hex-255/I2C-Sensorboard/README.md

# I2C-Sensorboard
Arduino Clone with multitude of I2C Sensors on-board meant as a learning platform for embedded programming
