hex-255/I2C-Sensorboard/I2C Sensor Board_V2/Write_Screenshots/16x2_Dimensions.png

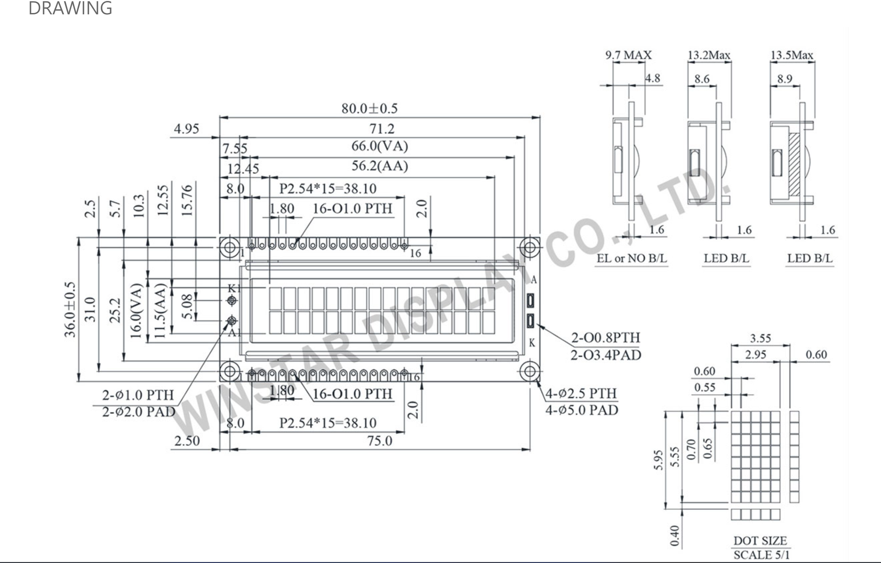
I2C Sensor Board_V2/Write_Screenshots/16x2_Dimensions.png
