hex-255/I2C-Sensorboard/I2C Sensor Board_V2/Write_Screenshots/Footpr_Assign_2.png

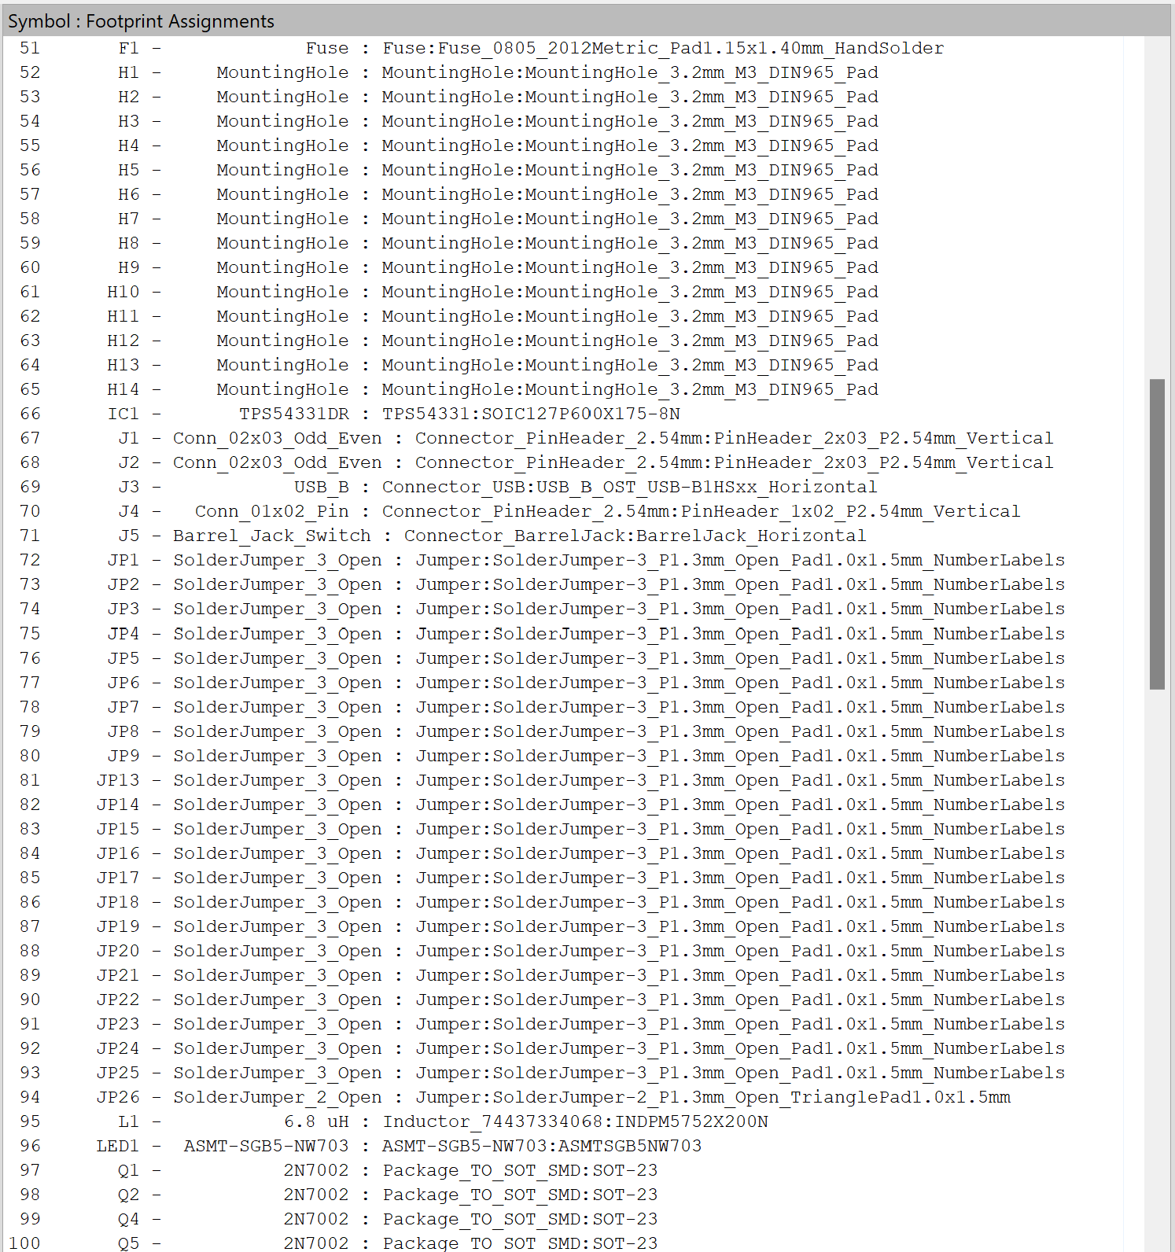
I2C Sensor Board_V2/Write_Screenshots/Footpr_Assign_2.png
