hex-255/I2C-Sensorboard/I2C Sensor Board_V2/Write_Screenshots/Footpr_Assign_3.png

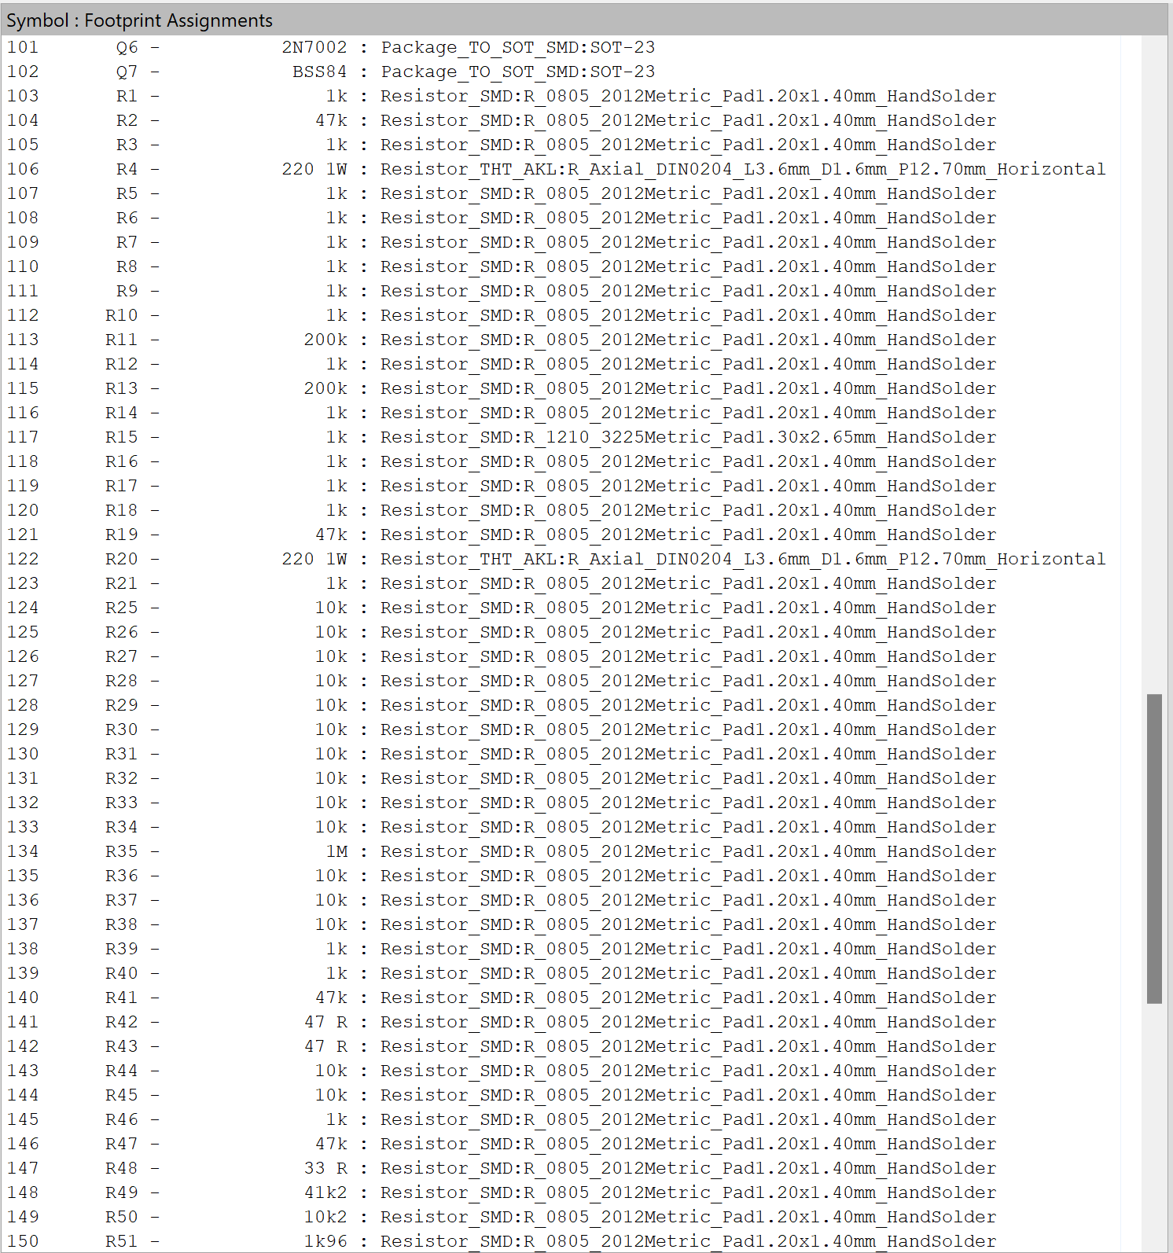
I2C Sensor Board_V2/Write_Screenshots/Footpr_Assign_3.png
