hex-255/I2C-Sensorboard/I2C Sensor Board_V2/Write_Screenshots/sch_DAC.png

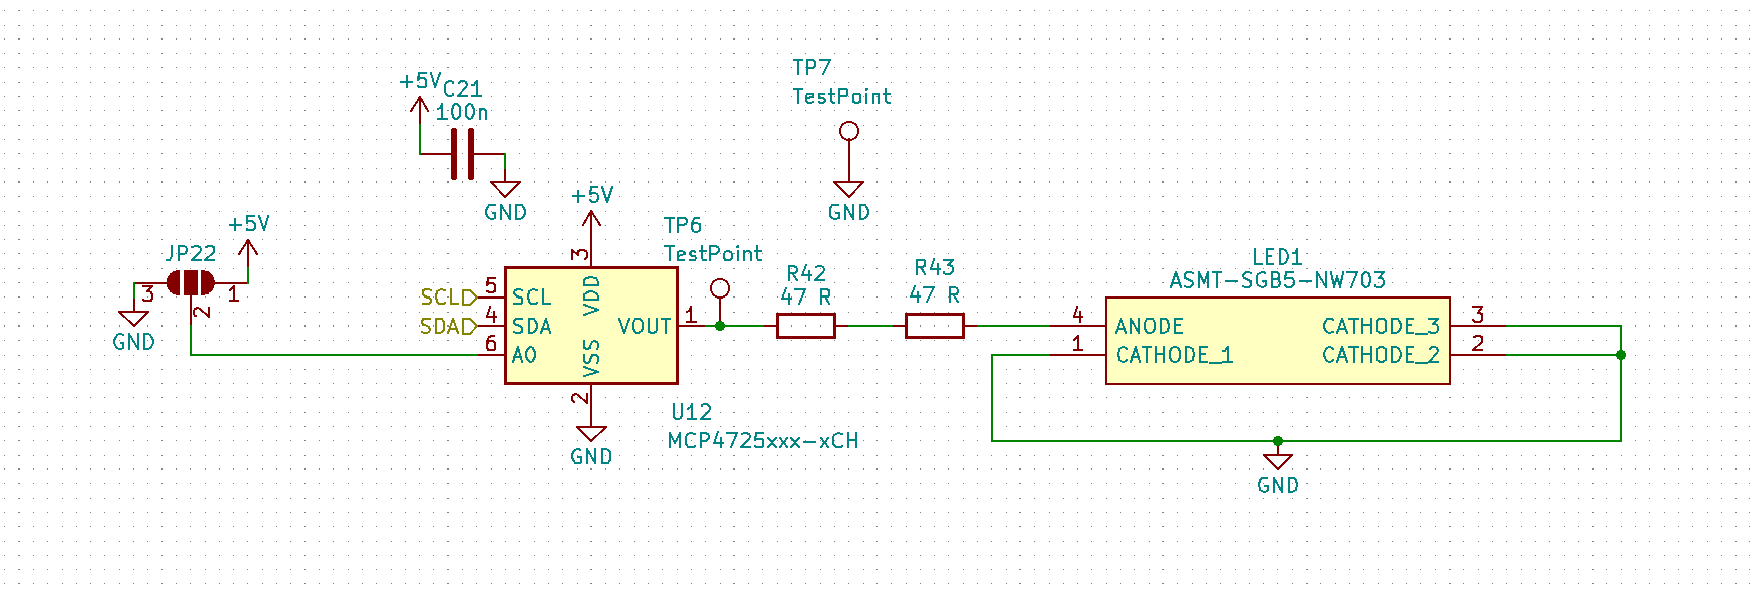
I2C Sensor Board_V2/Write_Screenshots/sch_DAC.png
