hex-255/I2C-Sensorboard/I2C Sensor Board_V2/Write_Screenshots/sch_EEPROM.png

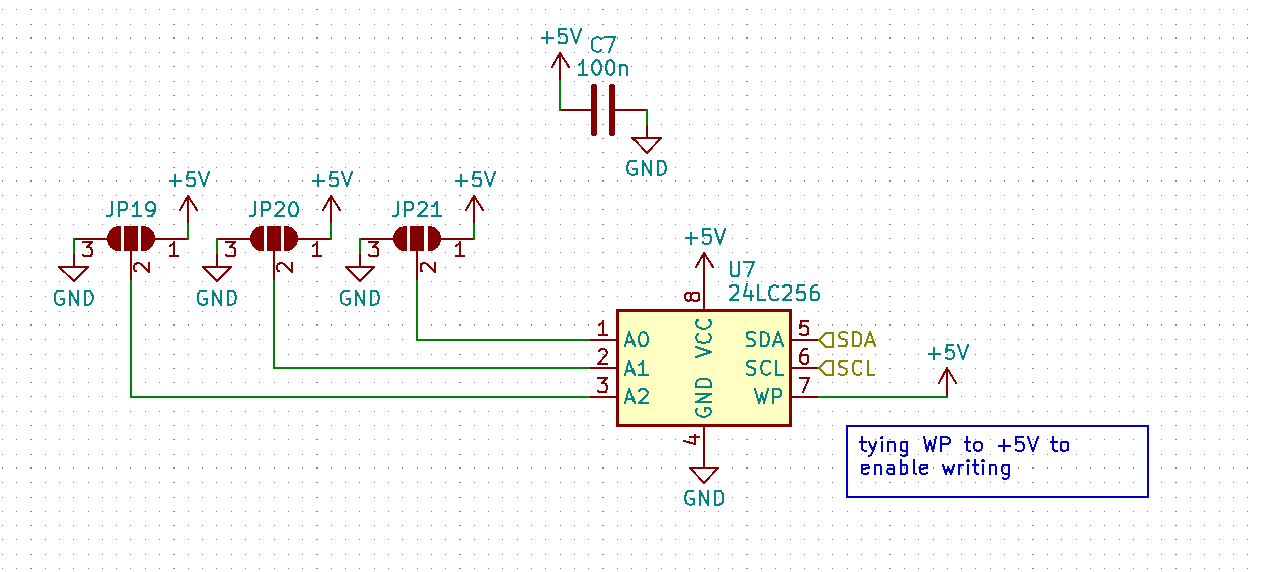
I2C Sensor Board_V2/Write_Screenshots/sch_EEPROM.png
