hex-255/I2C-Sensorboard/I2C Sensor Board_V2/Write_Screenshots/sch_LM75.png

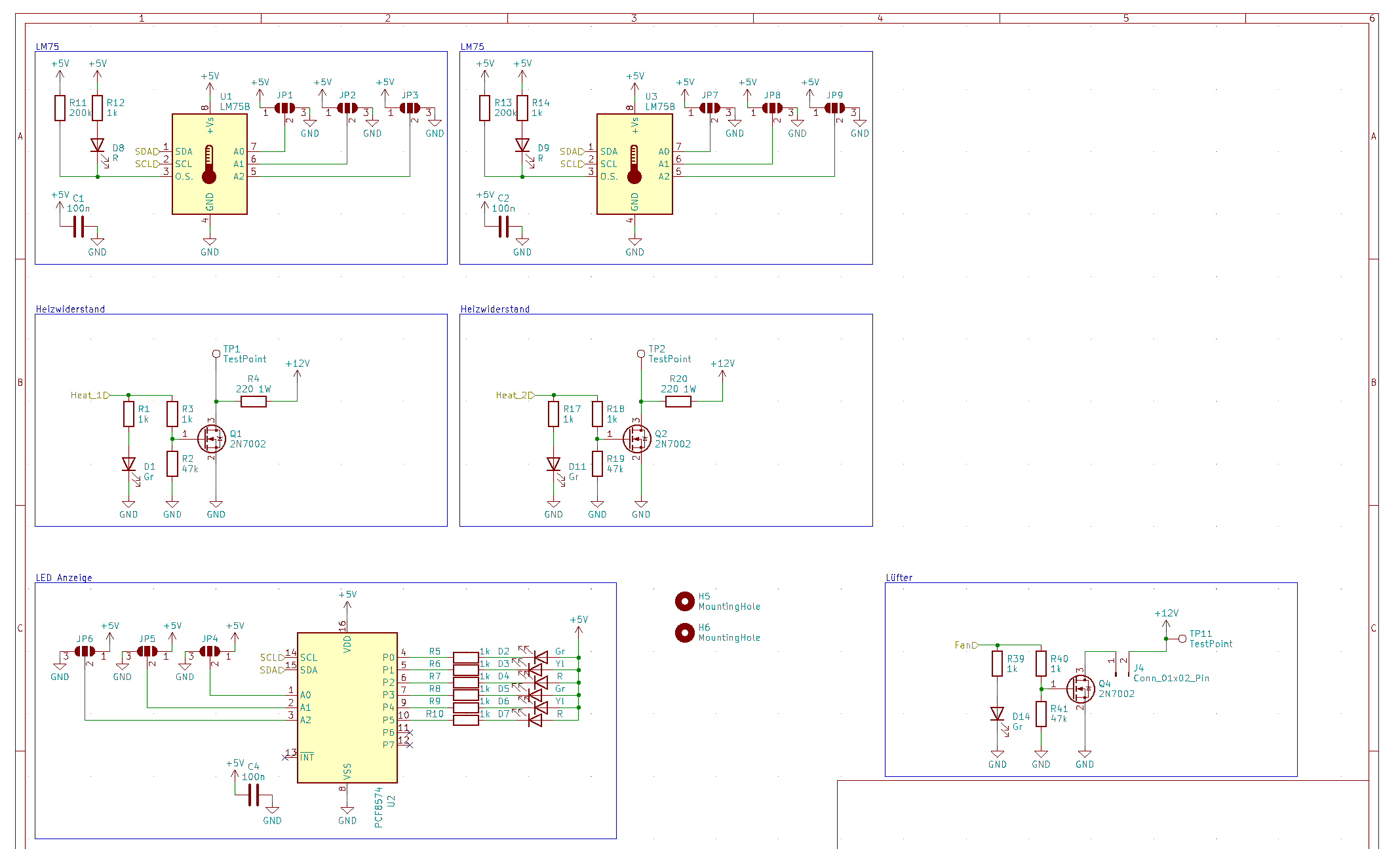
I2C Sensor Board_V2/Write_Screenshots/sch_LM75.png
