hex-255/I2C-Sensorboard/I2C Sensor Board_V2/Component_Placement.png

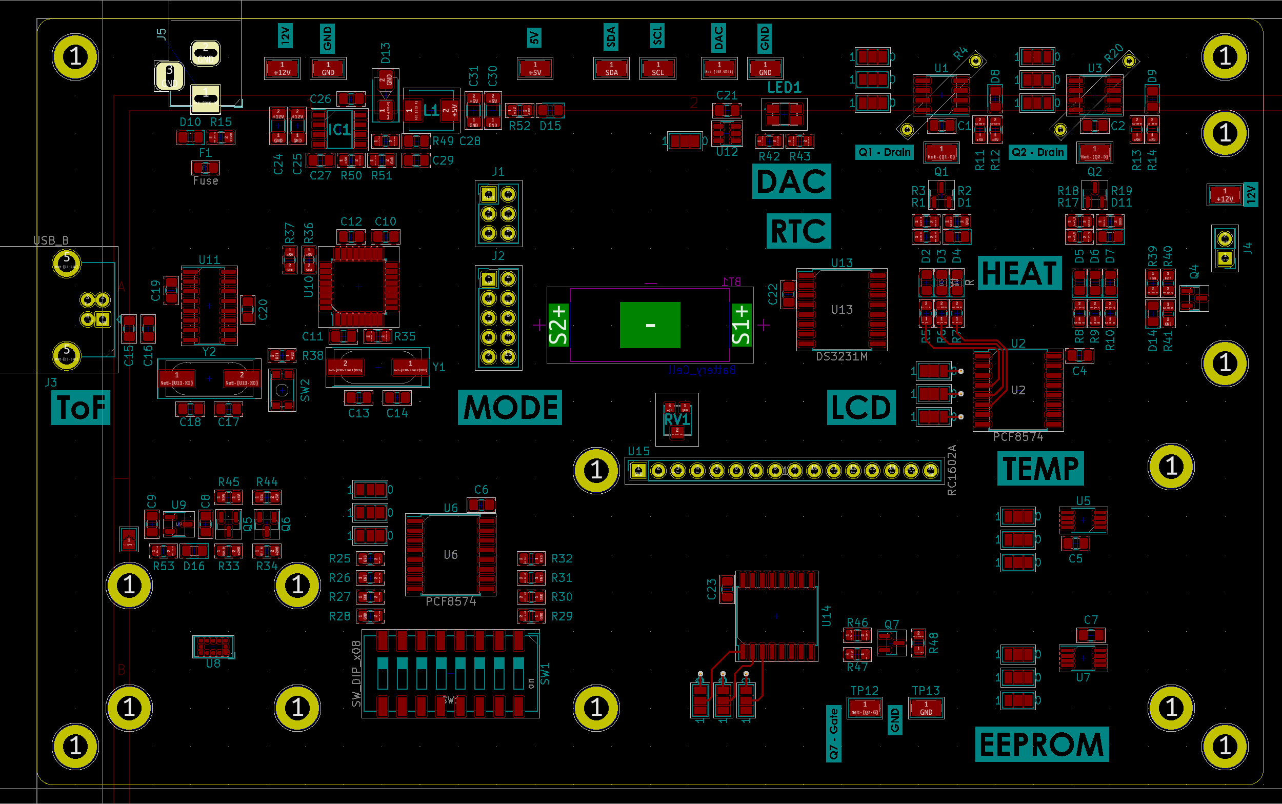
I2C Sensor Board_V2/Component_Placement.png
