hex-255/I2C-Sensorboard/I2C Sensor Board_V2/I2C Sensor Board_V2.step

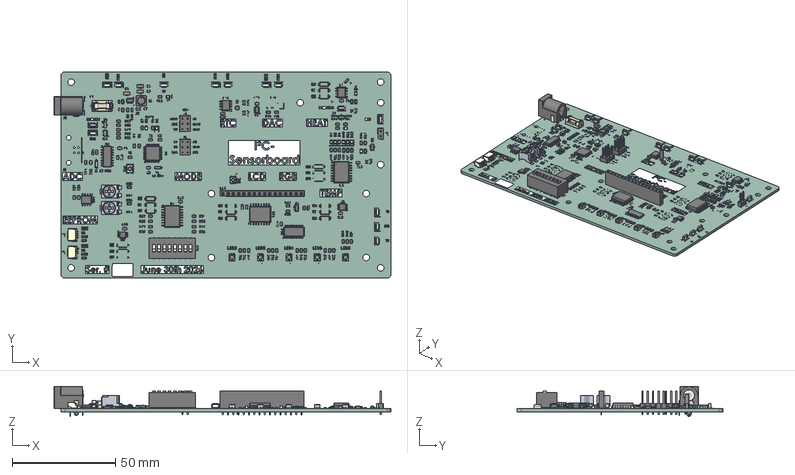
[picture p19: CAD file, 2026-10-06]
I2C Sensor Board_V2/I2C Sensor Board_V2.step
163.3 x 100.0 x 14.6 mm
R_0805_2012Metric x 59
150141M173100 x 10
SOIC-8_3.9x4.9mm_P1.27mm x 3
shielding ring x 3
core
coil
C_0805_2012Metric x 22
SOT-23-6
SOIC-16W_7.5x10.3mm_P1.27mm x 3
LED_0805_2012Metric x 12
CSTNE12M0G550000R0 x 2
SM04B-SRSS-TB(LF)(SN)--3DModel-STEP-269445 x 2
Crystal_Round_D2.0mm_Vertical
SW_DIP_SPSTx08_Slide_9.78x22.5mm_W8.61mm_P2.54mm
TC33X-2-103E
TQFP-32_7x7mm_P0.8mm
PinsArrayL x 2
FilletPinR
SOT-23 x 3
154005-DR
TSSOP-28_4.4x9.7mm_P0.65mm
N6L50T0S-CARCASA x 2
N6L50T0S-TERMINAL COLECTOR x 2
N6L50T0S-PLACA x 2
N6L50T0S-PORTACURSOR x 2
N6L50T0S-TOPE x 2
BarrelJack_Horizontal
SOIC-16_3.9x9.9mm_P1.27mm
PinHeader_2x03_P2.54mm_Vertical x 2
PinHeader_1x02_P2.54mm_Vertical
MSOP-8_3x3mm_P0.65mm x 2
KMR221GLFS--3DModel-STEP-56544
PinSocket_1x16_P2.54mm_Vertical
PinsArrayR
TSOT-23-6
C_1206_3216Metric x 3
I2C Sensor Board_V2_silkscreen x 2
I2C Sensor Board_V2_PCB
