hex-255/I2C-Sensorboard/I2C Sensor Board_V2/I2C Sensor Board_V2.kicad_pcb

## KiCad design I2C Sensor Board_V2/I2C Sensor Board_V2.kicad_pcb (2026-10-06)

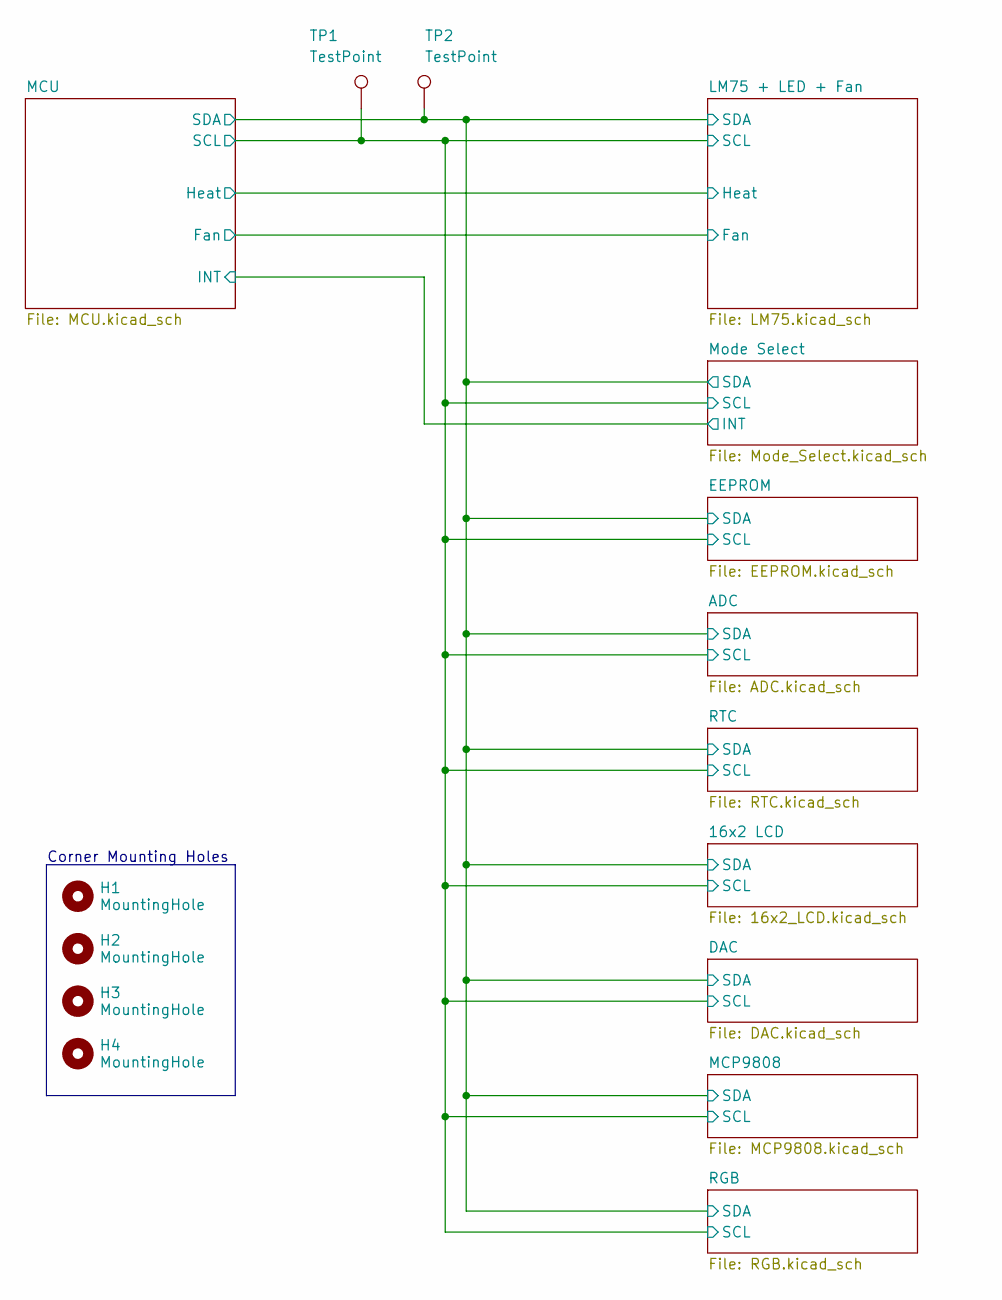
[picture p20: schematic I2C Sensor Board_V2.kicad_sch]

Parts:
H1, H2, H3, H4: MountingHole; MountingHole_3.2mm_M3_DIN965_Pad
TP1, TP2: TestPoint; Testpoint_5019_HandSolder

Connections:
/MCU/SCL: TP1.1 (1_1); also elsewhere on the board
/MCU/SDA: TP2.1 (1_1); also elsewhere on the board

Notes on the sheet:
Corner Mounting Holes

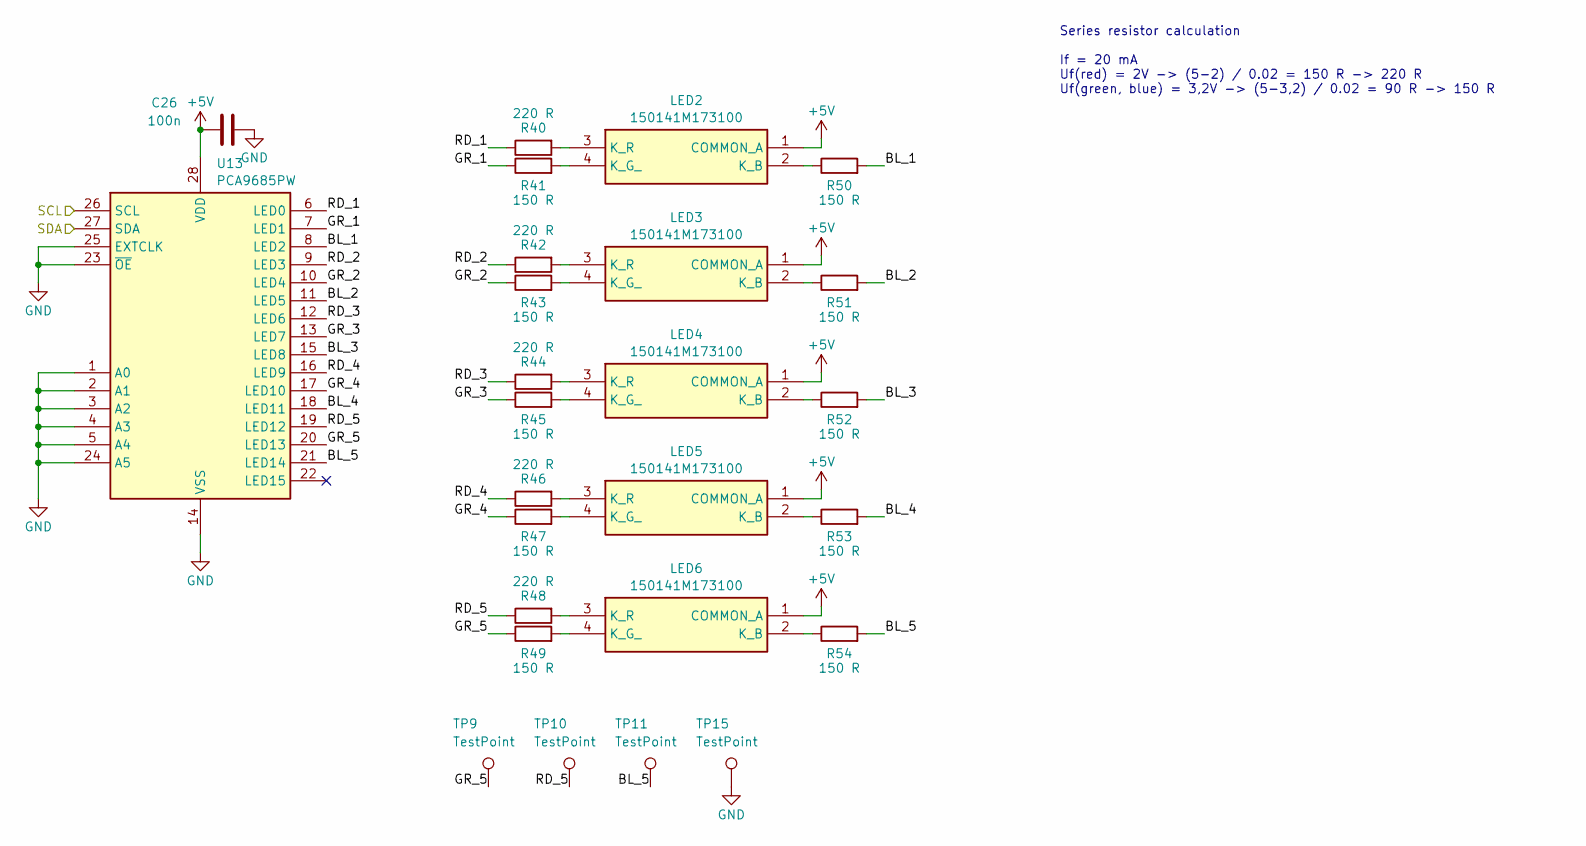
[picture p21: schematic RGB.kicad_sch]

Parts:
C26: 100n; C_0805_2012Metric_Pad1.18x1.45mm_HandSolder
LED2, LED3, LED4, LED5, LED6: 150141M173100; Manufacturer_Part_Number 150141M173100; Mouser Part Number 710-150141M173100
R40, R42, R44, R46, R48: 220 R; R_0805_2012Metric_Pad1.20x1.40mm_HandSolder
R41, R43, R45, R47, R49, R50, R51, R52, R53, R54: 150 R; R_0805_2012Metric_Pad1.20x1.40mm_HandSolder
TP9, TP10, TP11, TP15: TestPoint; Testpoint_5019_HandSolder
U13: PCA9685PW; TSSOP-28_4.4x9.7mm_P0.65mm

Connections:
+5V: C26.1, LED2.1 (COMMON_A), LED3.1 (COMMON_A), LED4.1 (COMMON_A), LED5.1 (COMMON_A), LED6.1 (COMMON_A), U13.28 (VDD); also elsewhere on the board
/MCU/SCL: U13.26 (SCL); also elsewhere on the board
/MCU/SDA: U13.27 (SDA); also elsewhere on the board
/RGB/BL_1: R50.2, U13.8 (LED2)
/RGB/BL_2: R51.2, U13.11 (LED5)
/RGB/BL_3: R52.2, U13.15 (LED8)
/RGB/BL_4: R53.2, U13.18 (LED11)
/RGB/BL_5: R54.2, TP11.1 (1_1), U13.21 (LED14)
/RGB/GR_1: R41.1, U13.7 (LED1)
/RGB/GR_2: R43.1, U13.10 (LED4)
/RGB/GR_3: R45.1, U13.13 (LED7)
/RGB/GR_4: R47.1, U13.17 (LED10)
/RGB/GR_5: R49.1, TP9.1 (1_1), U13.20 (LED13)
/RGB/RD_1: R40.1, U13.6 (LED0)
/RGB/RD_2: R42.1, U13.9 (LED3)
/RGB/RD_3: R44.1, U13.12 (LED6)
/RGB/RD_4: R46.1, U13.16 (LED9)
/RGB/RD_5: R48.1, TP10.1 (1_1), U13.19 (LED12)
GND: C26.2, TP15.1, U13.1 (A0), U13.2 (A1), U13.3 (A2), U13.4 (A3), U13.5 (A4), U13.14 (VSS), U13.23 (~OE), U13.24 (A5), U13.25 (EXTCLK); also elsewhere on the board
unnamed: LED2.2 (K_B), R50.1
unnamed: LED2.4 (K_G_), R41.2
unnamed: LED2.3 (K_R), R40.2
unnamed: LED3.2 (K_B), R51.1
unnamed: LED3.4 (K_G_), R43.2
unnamed: LED3.3 (K_R), R42.2
unnamed: LED4.2 (K_B), R52.1
unnamed: LED4.4 (K_G_), R45.2
unnamed: LED4.3 (K_R), R44.2
unnamed: LED5.2 (K_B), R53.1
unnamed: LED5.4 (K_G_), R47.2
unnamed: LED5.3 (K_R), R46.2
unnamed: LED6.2 (K_B), R54.1
unnamed: LED6.4 (K_G_), R49.2
unnamed: LED6.3 (K_R), R48.2

Notes on the sheet:
Series resistor calculation If = 20 mA Uf(red) = 2V -> (5-2) / 0.02 = 150 R -> 220 R Uf(green, blue) = 3,2V -> (5-3,2) / 0.02 = 90 R -> 150 R

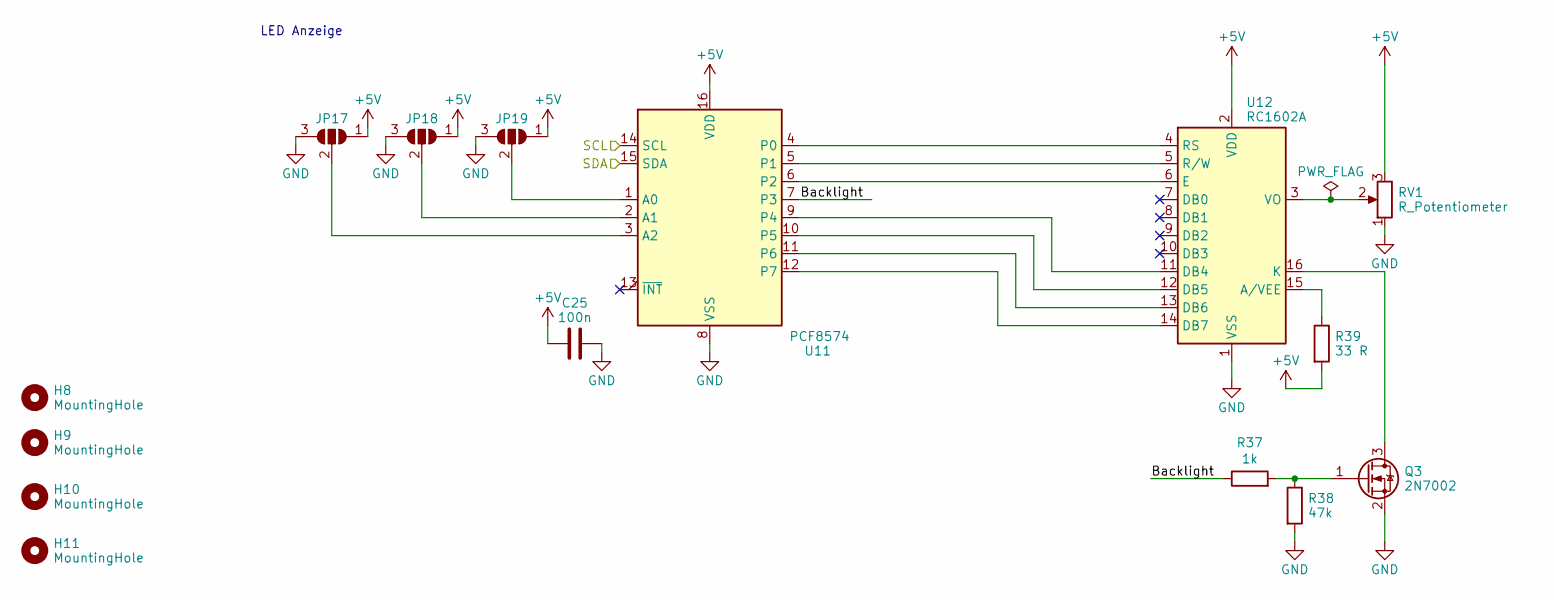
[picture p22: schematic 16x2_LCD.kicad_sch]

Parts:
C25: 100n; C_0805_2012Metric_Pad1.18x1.45mm_HandSolder
H8, H9, H10, H11: MountingHole; MountingHole_3.2mm_M3_DIN965_Pad
JP17, JP18, JP19: SolderJumper_3_Open; SolderJumper-3_P1.3mm_Open_Pad1.0x1.5mm_NumberLabels
Q3: 2N7002; SOT-23
R37: 1k; R_0805_2012Metric_Pad1.20x1.40mm_HandSolder
R38: 47k; R_0805_2012Metric_Pad1.20x1.40mm_HandSolder
R39: 33 R; R_0805_2012Metric_Pad1.20x1.40mm_HandSolder
RV1: R_Potentiometer; TRIM_TC33X-2-103E
U11: PCF8574; SOIC-16W_7.5x10.3mm_P1.27mm
U12: RC1602A; PinSocket_1x16_P2.54mm_Vertical

Connections:
+5V: C25.1, JP17.1 (A), JP18.1 (A), JP19.1 (A), R39.2, RV1.3, U11.16 (VDD), U12.2 (VDD); also elsewhere on the board
/16x2 LCD/Backlight: R37.1, U11.7 (P3)
/MCU/SCL: U11.14 (SCL); also elsewhere on the board
/MCU/SDA: U11.15 (SDA); also elsewhere on the board
GND: C25.2, JP17.3 (B), JP18.3 (B), JP19.3 (B), Q3.2 (S), R38.2, RV1.1, U11.8 (VSS), U12.1 (VSS); also elsewhere on the board
unnamed: JP17.2 (C), U11.3 (A2)
unnamed: JP18.2 (C), U11.2 (A1)
unnamed: JP19.2 (C), U11.1 (A0)
unnamed: Q3.3 (D), U12.16 (K)
unnamed: Q3.1 (G), R37.2, R38.1
unnamed: U11.4 (P0), U12.4 (RS)
unnamed: U11.5 (P1), U12.5 (R/W)
unnamed: U11.6 (P2), U12.6 (E)
unnamed: U11.9 (P4), U12.11 (DB4)
unnamed: U11.10 (P5), U12.12 (DB5)
unnamed: U11.11 (P6), U12.13 (DB6)
unnamed: U11.12 (P7), U12.14 (DB7)
unnamed: R39.1, U12.15 (A/VEE)
unnamed: RV1.2, U12.3 (VO)

Notes on the sheet:
LED Anzeige

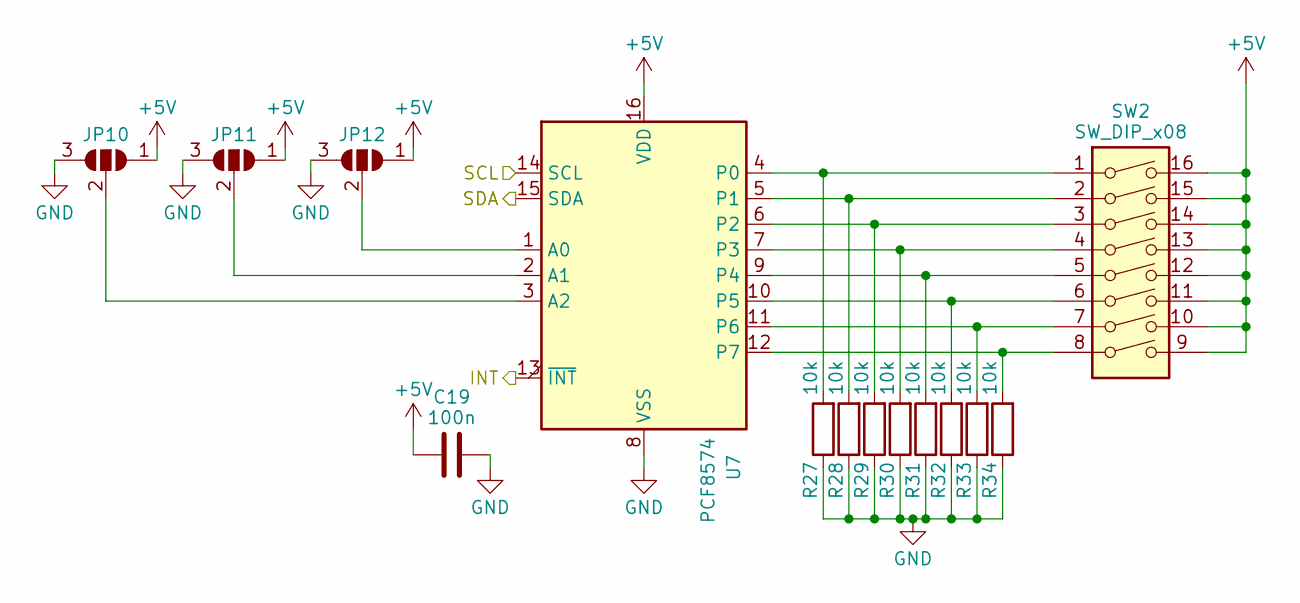
[picture p23: schematic Mode_Select.kicad_sch]

Parts:
C19: 100n; C_0805_2012Metric_Pad1.18x1.45mm_HandSolder
JP10, JP11, JP12: SolderJumper_3_Open; SolderJumper-3_P1.3mm_Open_Pad1.0x1.5mm_NumberLabels
R27, R28, R29, R30, R31, R32, R33, R34: 10k; R_0805_2012Metric_Pad1.20x1.40mm_HandSolder
SW2: SW_DIP_x08; SW_DIP_SPSTx08_Slide_9.78x22.5mm_W8.61mm_P2.54mm
U7: PCF8574; SOIC-16W_7.5x10.3mm_P1.27mm

Connections:
+5V: C19.1, JP10.1 (A), JP11.1 (A), JP12.1 (A), SW2.9, SW2.10, SW2.11, SW2.12, SW2.13, SW2.14, SW2.15, SW2.16, U7.16 (VDD); also elsewhere on the board
/MCU/INT: U7.13 (~INT); also elsewhere on the board
/MCU/SCL: U7.14 (SCL); also elsewhere on the board
/MCU/SDA: U7.15 (SDA); also elsewhere on the board
GND: C19.2, JP10.3 (B), JP11.3 (B), JP12.3 (B), R27.1, R28.1, R29.1, R30.1, R31.1, R32.1, R33.1, R34.1, U7.8 (VSS); also elsewhere on the board
unnamed: JP10.2 (C), U7.3 (A2)
unnamed: JP11.2 (C), U7.2 (A1)
unnamed: JP12.2 (C), U7.1 (A0)
unnamed: R27.2, SW2.1, U7.4 (P0)
unnamed: R28.2, SW2.2, U7.5 (P1)
unnamed: R29.2, SW2.3, U7.6 (P2)
unnamed: R30.2, SW2.4, U7.7 (P3)
unnamed: R31.2, SW2.5, U7.9 (P4)
unnamed: R32.2, SW2.6, U7.10 (P5)
unnamed: R33.2, SW2.7, U7.11 (P6)
unnamed: R34.2, SW2.8, U7.12 (P7)

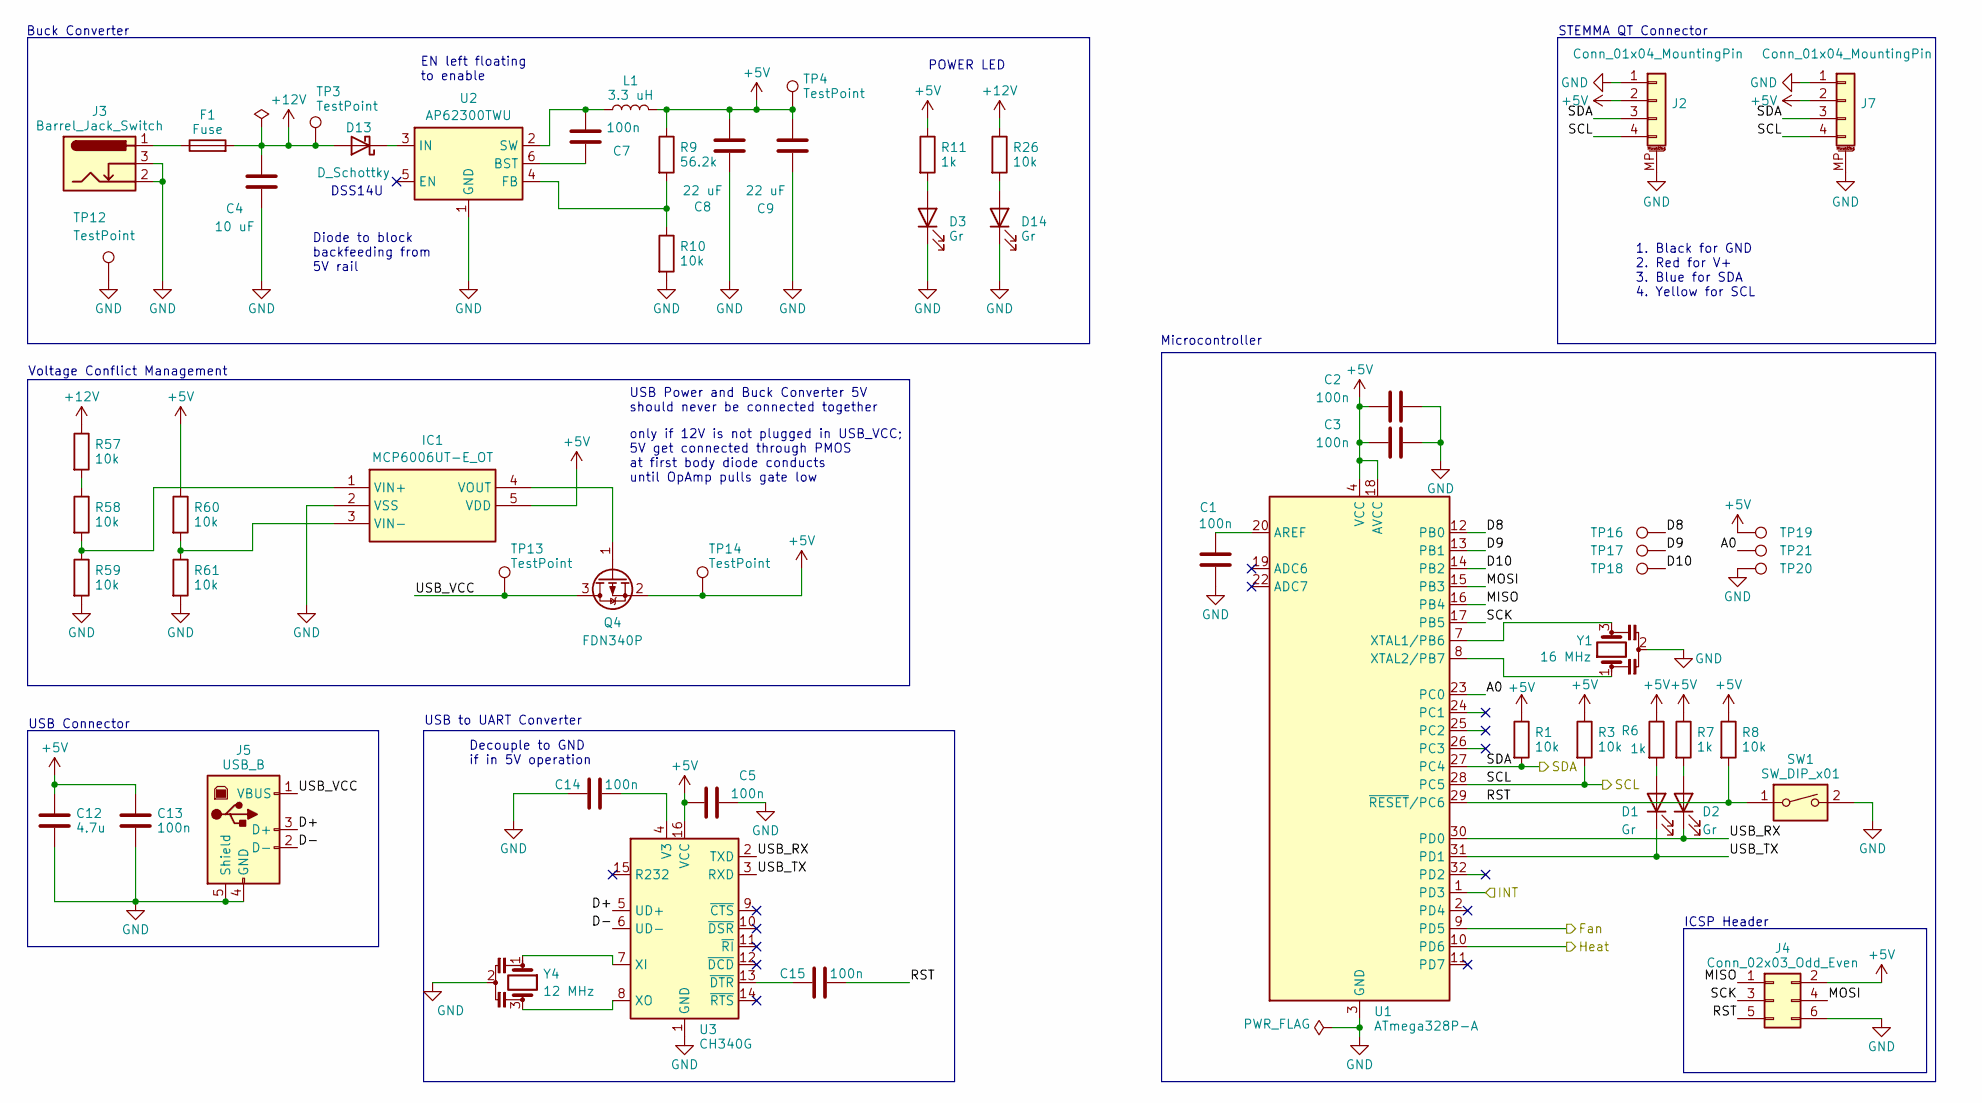
[picture p24: schematic MCU.kicad_sch]

Parts:
C1, C2, C3, C5, C7, C13, C14, C15: 100n; C_0805_2012Metric_Pad1.18x1.45mm_HandSolder
C4: 10 uF; C_1206_3216Metric_Pad1.33x1.80mm_HandSolder
C8, C9: 22 uF; C_1206_3216Metric_Pad1.33x1.80mm_HandSolder
C12: 4.7u; C_0805_2012Metric_Pad1.18x1.45mm_HandSolder
D1, D2, D3, D14: Gr; LED_0805_2012Metric_Pad1.15x1.40mm_HandSolder
D13: D_Schottky; D_SOD-123F
F1: Fuse; 154005DR
IC1: MCP6006UT-E_OT; SOT95P280X145-5N; Manufacturer_Part_Number MCP6006UT-E/OT; Mouser Part Number 579-MCP6006UT-E/OT
J2, J7: Conn_01x04_MountingPin; JST_SH_SM04B-SRSS-TB_1x04-1MP_P1.00mm_Horizontal
J3: Barrel_Jack_Switch; BarrelJack_Horizontal
J4: Conn_02x03_Odd_Even; PinHeader_2x03_P2.54mm_Vertical
J5: USB_B; USB_B_OST_USB-B1HSxx_Horizontal
L1: 3.3 uH; IND_WE-HEPC_5030_WRE
Q4: FDN340P; SOT-23
R1, R3, R8, R10, R26, R57, R58, R59, R60, R61: 10k; R_0805_2012Metric_Pad1.20x1.40mm_HandSolder
R6, R7, R11: 1k; R_0805_2012Metric_Pad1.20x1.40mm_HandSolder
R9: 56.2k; R_0805_2012Metric_Pad1.20x1.40mm_HandSolder
SW1: SW_DIP_x01; SW_Push_1P1T_NO_CK_KMR2
TP3, TP4, TP12, TP13, TP14: TestPoint; Testpoint_5019_HandSolder
TP16, TP17, TP18, TP19, TP20, TP21: TestPoint; TestPoint_THTPad_D1.5mm_Drill0.7mm
U1: ATmega328P-A; TQFP-32_7x7mm_P0.8mm
U2: AP62300TWU; TSOT-23-6
U3: CH340G; SOIC-16_3.9x9.9mm_P1.27mm
Y1: 16 MHz; OSC_CSTNE12M0G550000R0
Y4: 12 MHz; OSC_CSTNE12M0G550000R0

Connections:
+5V: C2.1, C3.1, C5.1, C8.2, C9.2, C12.2, C13.2, IC1.5 (VDD), J2.2, J4.2, J7.2, L1.2, Q4.2 (S), R1.1, R3.1, R6.1, R7.1, R8.1, R9.1, R11.1, R60.1, TP4.1 (1_1), TP14.1 (1_1), TP19.1 (1_1), U1.4 (VCC), U1.6 (VCC), U1.18 (AVCC), U3.16 (VCC); also elsewhere on the board
+12V: C4.2, D13.2 (A), F1.2, R26.1, R57.1, TP3.1 (1_1); also elsewhere on the board
/LM75 + LED + Fan/Fan: U1.9 (PD5); also elsewhere on the board
/LM75 + LED + Fan/Heat: U1.10 (PD6); also elsewhere on the board
/MCU/A0: TP21.1 (1_1), U1.23 (PC0)
/MCU/D8: TP16.1 (1_1), U1.12 (PB0)
/MCU/D9: TP17.1 (1_1), U1.13 (PB1)
/MCU/D10: TP18.1 (1_1), U1.14 (PB2)
/MCU/D+: J5.3 (D+), U3.5 (UD+)
/MCU/D-: J5.2 (D-), U3.6 (UD-)
/MCU/INT: U1.1 (PD3); also elsewhere on the board
/MCU/MISO: J4.1, U1.16 (PB4)
/MCU/MOSI: J4.4, U1.15 (PB3)
/MCU/RST: C15.2, J4.5, R8.2, SW1.1, U1.29 (~RESET/PC6)
/MCU/SCK: J4.3, U1.17 (PB5)
/MCU/SCL: J2.4, J7.4, R3.2, U1.28 (PC5); also elsewhere on the board
/MCU/SDA: J2.3, J7.3, R1.2, U1.27 (PC4); also elsewhere on the board
/MCU/USB_RX: D2.1 (K), U1.30 (PD0), U3.2 (TXD)
/MCU/USB_TX: D1.1 (K), U1.31 (PD1), U3.3 (RXD)
/MCU/USB_VCC: J5.1 (VBUS), Q4.3 (D), TP13.1 (1_1)
GND: C1.1, C2.2, C3.2, C4.1, C5.2, C8.1, C9.1, C12.1, C13.1, C14.1, D3.1 (K), D14.1 (K), IC1.2 (VSS), J2.1, J2.MP (MountPin), J3.2, J3.3, J4.6, J5.4 (GND), J5.5 (Shield), J7.1, J7.MP (MountPin), R10.2, R59.2, R61.2, SW1.2, TP12.1 (1_1), TP20.1 (1_1), U1.3 (GND), U1.5 (GND), U1.21 (GND), U2.1 (GND), U3.1 (GND), Y1.2, Y4.2; also elsewhere on the board
unnamed: D1.2 (A), R6.2
unnamed: D2.2 (A), R7.2
unnamed: D3.2 (A), R11.2
unnamed: D13.1 (K), U2.3 (IN)
unnamed: D14.2 (A), R26.2
unnamed: F1.1, J3.1
unnamed: IC1.1 (VIN+), R58.2, R59.1
unnamed: IC1.3 (VIN-), R60.2, R61.1
unnamed: IC1.4 (VOUT), Q4.1 (G)
unnamed: R57.2, R58.1
unnamed: C1.2, U1.20 (AREF)
unnamed: U1.7 (XTAL1/PB6), Y1.3
unnamed: U1.8 (XTAL2/PB7), Y1.1
unnamed: C7.1, U2.6 (BST)
unnamed: R9.2, R10.1, U2.4 (FB)
unnamed: C7.2, L1.1, U2.2 (SW)
unnamed: C14.2, U3.4 (V3)
unnamed: U3.7 (XI), Y4.1
unnamed: U3.8 (XO), Y4.3
unnamed: C15.1, U3.13 (~DTR)

Notes on the sheet:
USB Connector
Microcontroller
USB to UART Converter
Voltage Conflict Management
POWER LED
DSS14U
1. Black for GND 2. Red for V+ 3. Blue for SDA 4. Yellow for SCL
USB Power and Buck Converter 5V should never be connected together
ICSP Header
STEMMA QT Connector
Decouple to GND if in 5V operation
Diode to block backfeeding from 5V rail
Buck Converter
only if 12V is not plugged in USB_VCC; 5V get connected through PMOS at first body diode conducts until OpAmp pulls gate low
EN left floating to enable

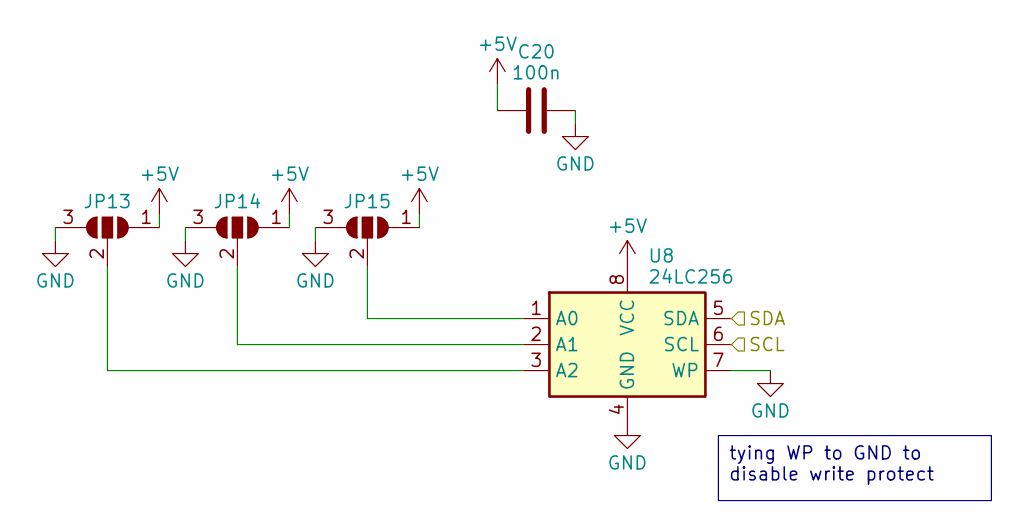
[picture p25: schematic EEPROM.kicad_sch]

Parts:
C20: 100n; C_0805_2012Metric_Pad1.18x1.45mm_HandSolder
JP13, JP14, JP15: SolderJumper_3_Open; SolderJumper-3_P1.3mm_Open_Pad1.0x1.5mm_NumberLabels
U8: 24LC256; MSOP-8_3x3mm_P0.65mm

Connections:
+5V: C20.1, JP13.1 (A), JP14.1 (A), JP15.1 (A), U8.8 (VCC); also elsewhere on the board
/MCU/SCL: U8.6 (SCL); also elsewhere on the board
/MCU/SDA: U8.5 (SDA); also elsewhere on the board
GND: C20.2, JP13.3 (B), JP14.3 (B), JP15.3 (B), U8.4 (GND), U8.7 (WP); also elsewhere on the board
unnamed: JP13.2 (C), U8.3 (A2)
unnamed: JP14.2 (C), U8.2 (A1)
unnamed: JP15.2 (C), U8.1 (A0)

Notes on the sheet:
tying WP to GND to disable write protect

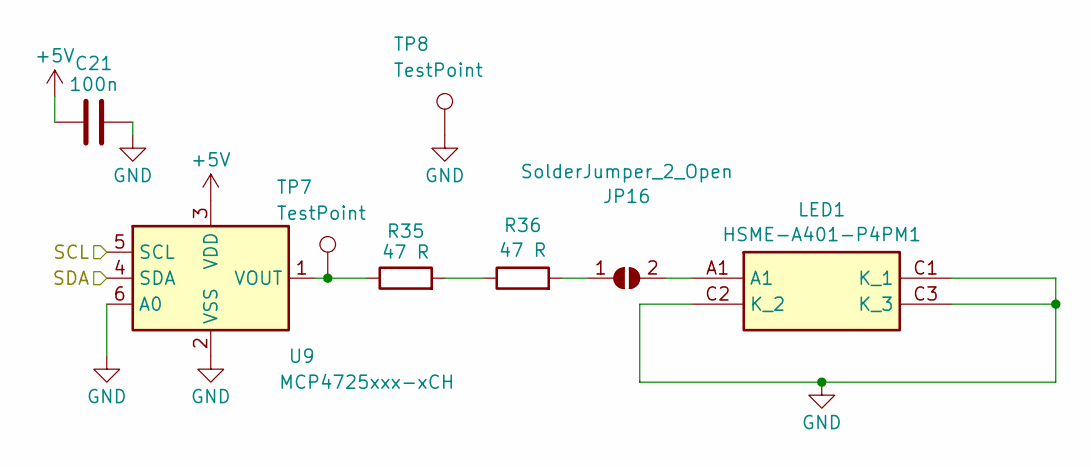
[picture p26: schematic DAC.kicad_sch]

Parts:
C21: 100n; C_0805_2012Metric_Pad1.18x1.45mm_HandSolder
JP16: SolderJumper_2_Open; SolderJumper-2_P1.3mm_Open_TrianglePad1.0x1.5mm
LED1: HSME-A401-P4PM1; HSMEA401P4PM1; Manufacturer_Part_Number HSME-A401-P4PM1; Mouser Part Number 630-HSME-A401-P4PM1
R35, R36: 47 R; R_0805_2012Metric_Pad1.20x1.40mm_HandSolder
TP7, TP8: TestPoint; Testpoint_5019_HandSolder
U9: MCP4725xxx-xCH; SOT-23-6

Connections:
+5V: C21.1, U9.3 (VDD); also elsewhere on the board
/MCU/SCL: U9.5 (SCL); also elsewhere on the board
/MCU/SDA: U9.4 (SDA); also elsewhere on the board
GND: C21.2, LED1.C1 (K_1), LED1.C2 (K_2), LED1.C3 (K_3), TP8.1 (1_1), U9.2 (VSS), U9.6 (A0); also elsewhere on the board
unnamed: JP16.1 (A), R36.2
unnamed: JP16.2 (B), LED1.A1
unnamed: R35.2, R36.1
unnamed: R35.1, TP7.1 (1_1), U9.1 (VOUT)

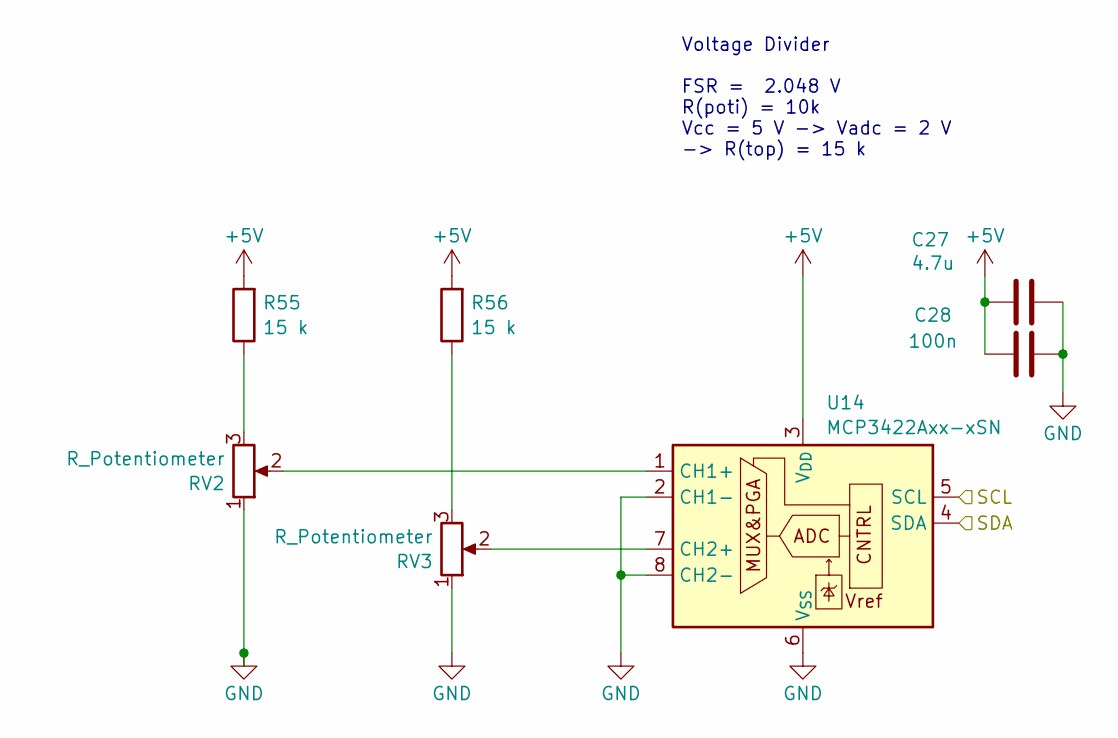
[picture p27: schematic ADC.kicad_sch]

Parts:
C27: 4.7u; C_0805_2012Metric_Pad1.18x1.45mm_HandSolder
C28: 100n; C_0805_2012Metric_Pad1.18x1.45mm_HandSolder
R55, R56: 15 k; R_0805_2012Metric_Pad1.20x1.40mm_HandSolder
RV2, RV3: R_Potentiometer; Piher_N6L50T8S
U14: MCP3422Axx-xSN; SOIC-8_3.9x4.9mm_P1.27mm

Connections:
+5V: C27.2, C28.1, R55.2, R56.2, U14.3 (V_{DD}); also elsewhere on the board
/MCU/SCL: U14.5 (SCL); also elsewhere on the board
/MCU/SDA: U14.4 (SDA); also elsewhere on the board
GND: C27.1, C28.2, RV2.1, RV3.1, U14.2 (CH1-), U14.6 (V_{SS}), U14.8 (CH2-); also elsewhere on the board
unnamed: R55.1, RV2.3
unnamed: R56.1, RV3.3
unnamed: RV2.2, U14.1 (CH1+)
unnamed: RV3.2, U14.7 (CH2+)

Notes on the sheet:
Voltage Divider FSR = 2.048 V R(poti) = 10k Vcc = 5 V -> Vadc = 2 V -> R(top) = 15 k

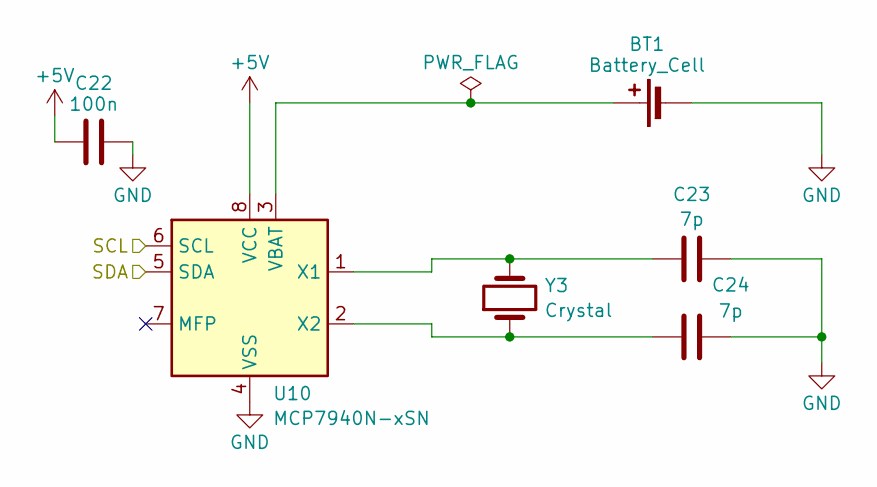
[picture p28: schematic RTC.kicad_sch]

Parts:
BT1: Battery_Cell; BAT_BC-2003
C22: 100n; C_0805_2012Metric_Pad1.18x1.45mm_HandSolder
C23, C24: 7p; C_0805_2012Metric_Pad1.18x1.45mm_HandSolder
U10: MCP7940N-xSN; SOIC-8_3.9x4.9mm_P1.27mm
Y3: Crystal; Crystal_Round_D2.0mm_Vertical

Connections:
+5V: C22.1, U10.8 (VCC); also elsewhere on the board
/MCU/SCL: U10.6 (SCL); also elsewhere on the board
/MCU/SDA: U10.5 (SDA); also elsewhere on the board
GND: BT1.2 (-), C22.2, C23.2, C24.2, U10.4 (VSS); also elsewhere on the board
unnamed: BT1.1 (+), U10.3 (VBAT)
unnamed: C23.1, U10.1 (X1), Y3.2
unnamed: C24.1, U10.2 (X2), Y3.1

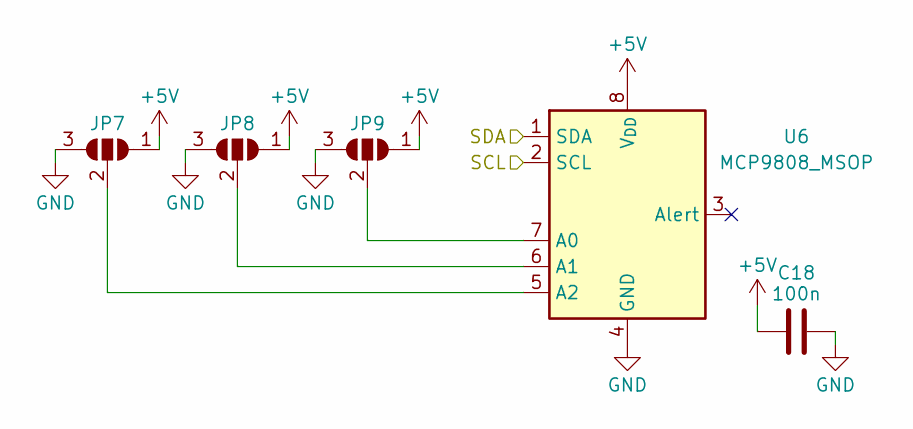
[picture p29: schematic MCP9808.kicad_sch]

Parts:
C18: 100n; C_0805_2012Metric_Pad1.18x1.45mm_HandSolder
JP7, JP8, JP9: SolderJumper_3_Open; SolderJumper-3_P1.3mm_Open_Pad1.0x1.5mm_NumberLabels
U6: MCP9808_MSOP; MSOP-8_3x3mm_P0.65mm

Connections:
+5V: C18.1, JP7.1 (A), JP8.1 (A), JP9.1 (A), U6.8 (V_{DD}); also elsewhere on the board
/MCU/SCL: U6.2 (SCL); also elsewhere on the board
/MCU/SDA: U6.1 (SDA); also elsewhere on the board
GND: C18.2, JP7.3 (B), JP8.3 (B), JP9.3 (B), U6.4 (GND); also elsewhere on the board
unnamed: JP7.2 (C), U6.5 (A2)
unnamed: JP8.2 (C), U6.6 (A1)
unnamed: JP9.2 (C), U6.7 (A0)

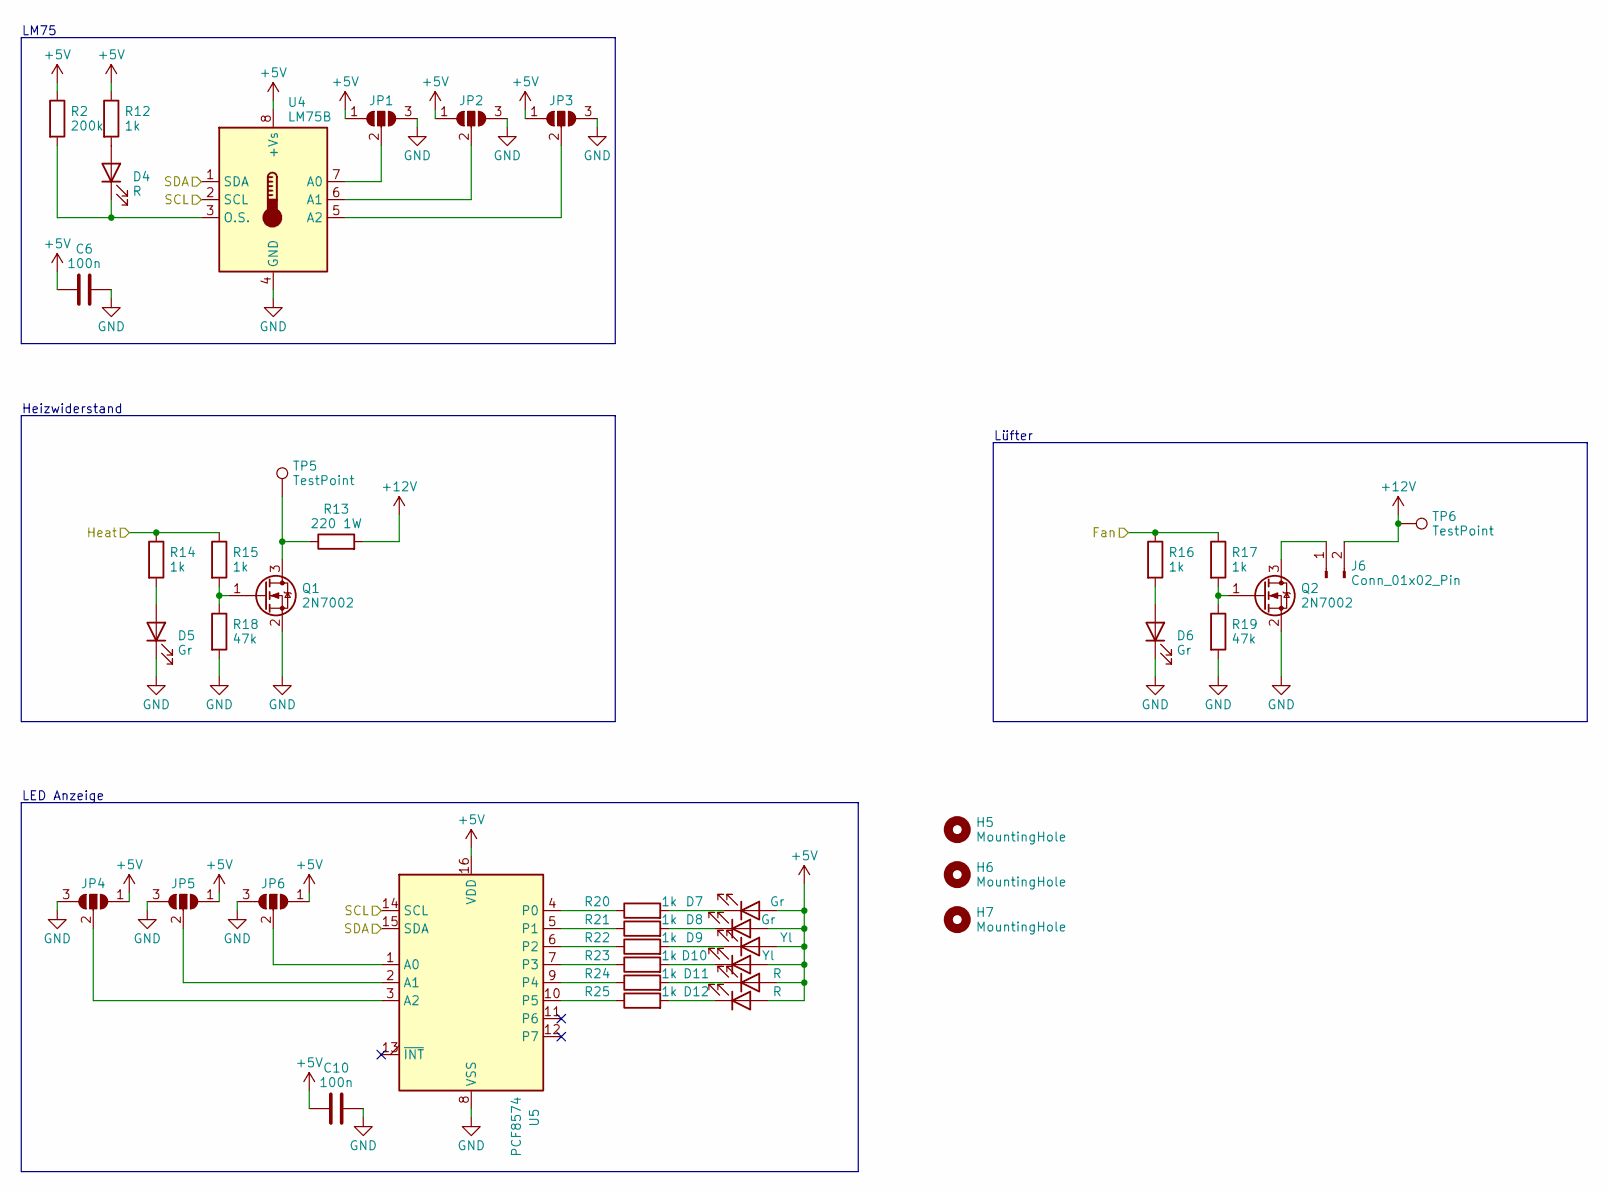
[picture p30: schematic LM75.kicad_sch]

Parts:
C6, C10: 100n; C_0805_2012Metric_Pad1.18x1.45mm_HandSolder
D4, D11, D12: R; LED_0805_2012Metric_Pad1.15x1.40mm_HandSolder
D5, D6, D7, D8: Gr; LED_0805_2012Metric_Pad1.15x1.40mm_HandSolder
D9, D10: Yl; LED_0805_2012Metric_Pad1.15x1.40mm_HandSolder
H5, H6, H7: MountingHole; MountingHole_3.2mm_M3_DIN965_Pad
J6: Conn_01x02_Pin; PinHeader_1x02_P2.54mm_Vertical
JP1, JP2, JP3, JP4, JP5, JP6: SolderJumper_3_Open; SolderJumper-3_P1.3mm_Open_Pad1.0x1.5mm_NumberLabels
Q1, Q2: 2N7002; SOT-23
R2: 200k; R_0805_2012Metric_Pad1.20x1.40mm_HandSolder
R12, R14, R15, R16, R17, R20, R21, R22, R23, R24, R25: 1k; R_0805_2012Metric_Pad1.20x1.40mm_HandSolder
R13: 220 1W; R_Axial_DIN0204_L3.6mm_D1.6mm_P12.70mm_Horizontal
R18, R19: 47k; R_0805_2012Metric_Pad1.20x1.40mm_HandSolder
TP5, TP6: TestPoint; Testpoint_5019_HandSolder
U4: LM75B; SOIC-8_3.9x4.9mm_P1.27mm
U5: PCF8574; SOIC-16W_7.5x10.3mm_P1.27mm

Connections:
+5V: C6.1, C10.1, D7.2 (A), D8.2 (A), D9.2 (A), D10.2 (A), D11.2 (A), D12.2 (A), JP1.1 (A), JP2.1 (A), JP3.1 (A), JP4.1 (A), JP5.1 (A), JP6.1 (A), R2.1, R12.1, U4.8 (+Vs), U5.16 (VDD); also elsewhere on the board
+12V: J6.2, R13.2, TP6.1 (1_1); also elsewhere on the board
/LM75 + LED + Fan/Fan: R16.1, R17.1; also elsewhere on the board
/LM75 + LED + Fan/Heat: R14.1, R15.1; also elsewhere on the board
/MCU/SCL: U4.2 (SCL), U5.14 (SCL); also elsewhere on the board
/MCU/SDA: U4.1 (SDA), U5.15 (SDA); also elsewhere on the board
GND: C6.2, C10.2, D5.1 (K), D6.1 (K), JP1.3 (B), JP2.3 (B), JP3.3 (B), JP4.3 (B), JP5.3 (B), JP6.3 (B), Q1.2 (S), Q2.2 (S), R18.2, R19.2, U4.4 (GND), U5.8 (VSS); also elsewhere on the board
unnamed: D4.2 (A), R12.2
unnamed: D4.1 (K), R2.2, U4.3 (O.S.)
unnamed: D5.2 (A), R14.2
unnamed: D6.2 (A), R16.2
unnamed: D7.1 (K), R20.2
unnamed: D8.1 (K), R21.2
unnamed: D9.1 (K), R22.2
unnamed: D10.1 (K), R23.2
unnamed: D11.1 (K), R24.2
unnamed: D12.1 (K), R25.2
unnamed: J6.1, Q2.3 (D)
unnamed: JP1.2 (C), U4.7 (A0)
unnamed: JP2.2 (C), U4.6 (A1)
unnamed: JP3.2 (C), U4.5 (A2)
unnamed: JP4.2 (C), U5.3 (A2)
unnamed: JP5.2 (C), U5.2 (A1)
unnamed: JP6.2 (C), U5.1 (A0)
unnamed: Q1.3 (D), R13.1, TP5.1 (1_1)
unnamed: Q1.1 (G), R15.2, R18.1
unnamed: Q2.1 (G), R17.2, R19.1
unnamed: R20.1, U5.4 (P0)
unnamed: R21.1, U5.5 (P1)
unnamed: R22.1, U5.6 (P2)
unnamed: R23.1, U5.7 (P3)
unnamed: R24.1, U5.9 (P4)
unnamed: R25.1, U5.10 (P5)

Notes on the sheet:
LM75
Lüfter
LED Anzeige
Heizwiderstand

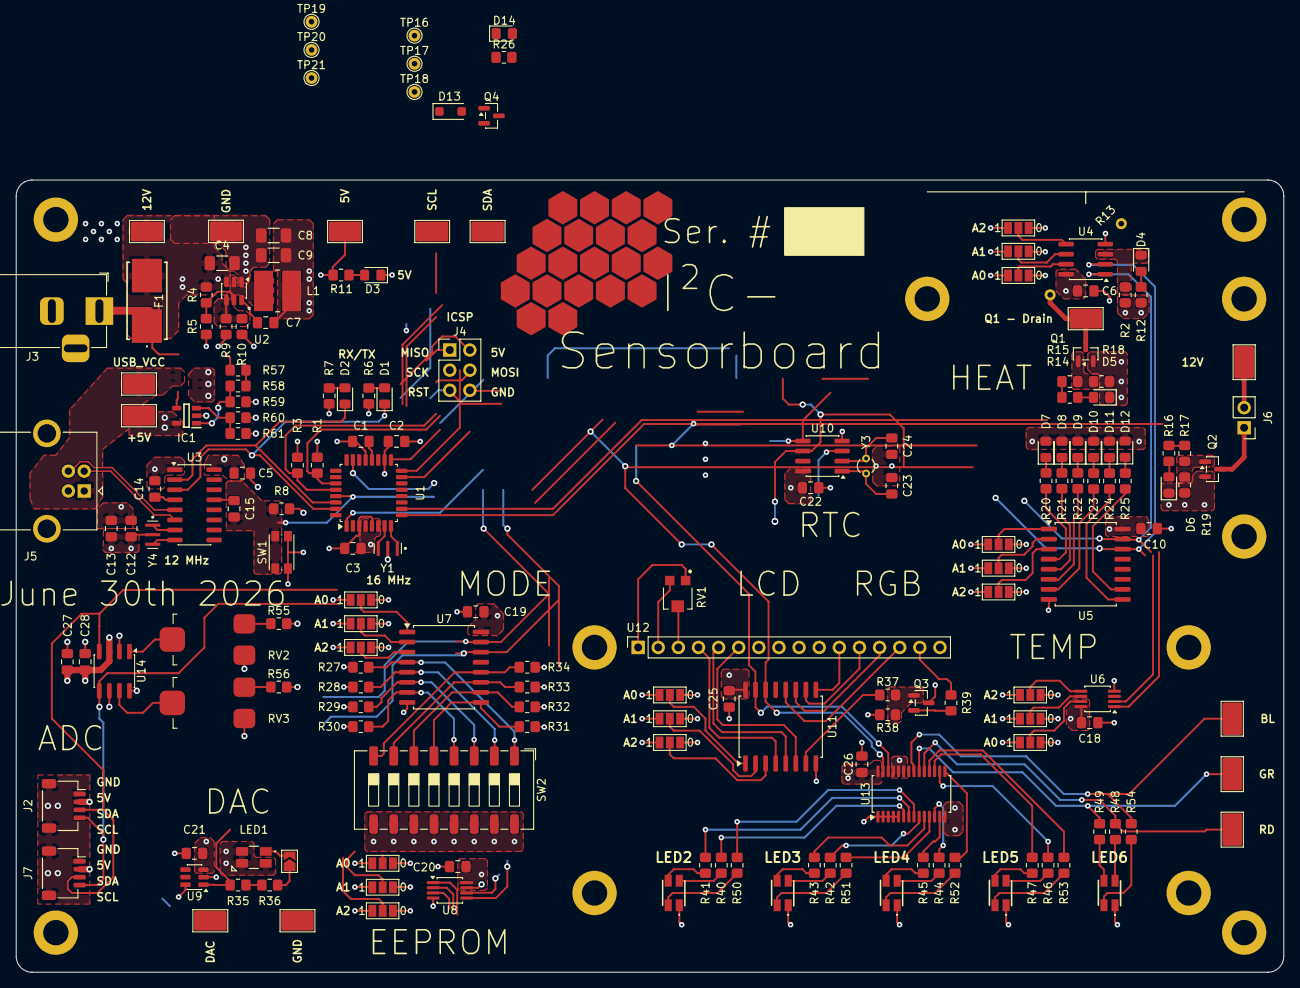
[picture p31: board I2C Sensor Board_V2.kicad_pcb from above]

Board: 4 copper layers, 160.0 x 100.0 mm, 192 parts (1 on the bottom side), 141 nets.

Other parts of the board:
R4, R5: 10k; R_0805_2012Metric_Pad1.20x1.40mm_HandSolder

Their connections:
+12V: R4.1; also elsewhere on the board
GND: R5.2; also elsewhere on the board
unnamed: R4.2, R5.1
